IoTopenTech/TTNMAD_CO2_FREE/presentacion/README.MD

Presentación para el montaje y configuración del sensor TTNMAD_CO2_FREE versión Wemos D1 mini, y conexiones para la versión TTGO LoRa32.
