IoTopenTech/TTNMAD_CO2_FREE/media/photo_2020-10-29_13-06-01.jpg

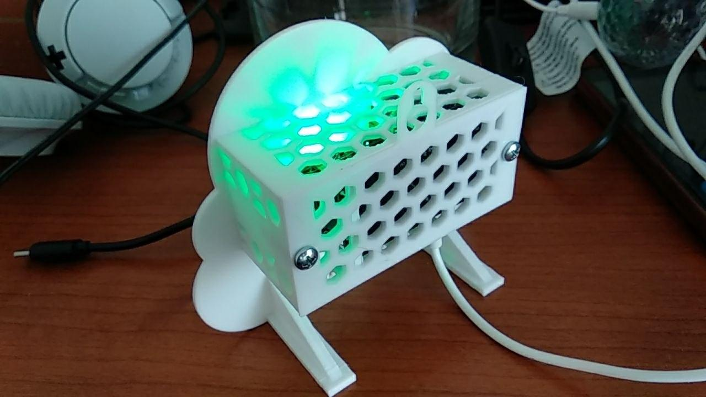
media/photo_2020-10-29_13-06-01.jpg
