IoTopenTech/TTNMAD_CO2_FREE/media/TTNMAD_CO2_FREE_youtube.png

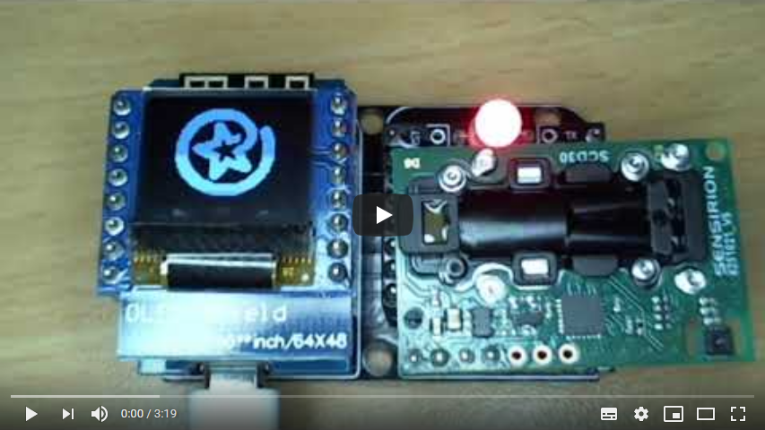
media/TTNMAD_CO2_FREE_youtube.png
