IoTopenTech/TTNMAD_CO2_FREE/presentacion/conexiones_TTGO_LoRa32_SCD30.jpg

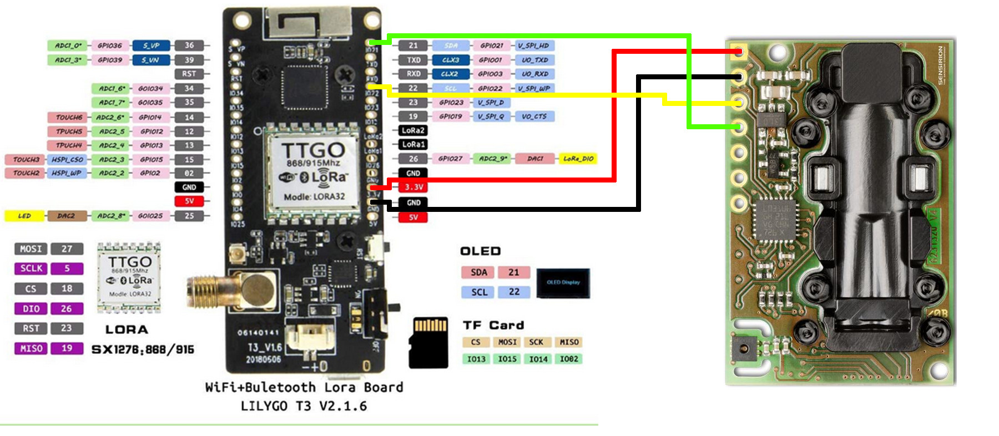
presentacion/conexiones_TTGO_LoRa32_SCD30.jpg
