IoTopenTech/TTNMAD_CO2_FREE/(threads)

Thread 1 (2020-11-09):

Calibrado del sensor

aseques, 2020-11-09:
Hola, mirando varios proyectos he visto que un tema típico es que el sensor de medicion se descalibra al cabo de unas horas de uso. Os ha pasado algo similar?

IoTopenTech, 2020-11-10:
No he observado ese problema @aseques
De hecho, el sensor que hemos elegido (SCD30) tiene un precio algo más elevado que otros, pero ofrece la ventaja de incluir una rutina continua de autocalibración.
Esta rutina exige mantenerlo encendido de forma continua durante al menos 7 días exponiéndolo al menos una hora al día a aire fresco (de este modo el sensor encuentra su referencia mínima).

aseques, 2020-11-11:
Grácias, ya vi que el precio era un el doble que otras opciones (por ejemplo MH-Z19B que usan en https://github.com/oskrs111/diy-co2-monitor), supongo que será por lo que comentais.

IoTopenTech, 2020-11-12:
El Z19B es también una buena opción, que de hecho estuvimos valorando, pero para nuestro caso de uso tenía la limitación principal de consumir casi 3 veces más que el SCD30.
Tampoco trae sensor de humedad, que lo compensa con un filtro de vapor.
Y algo menos de precisión.
Es 3 veces más barato... pero nuestro caso está dirigido a usuarios sin mucha experiencia en sensores, por lo que evitar la calibración es esencial, y aquí una marca de prestigio como Sensirion terminó de inclinar la balanza.

Enoasv, 2021-01-20:
Hola,
Una duda que tengo con el autocalibrado, por si tenéis más información que la que aporta el datasheet...
Con la aplicación para este proyecto se activa siempre la autocalibracioón, pero ¿Que sucede si está encendido y no se cumple el tener al menos una hora al dia con aire "fresco" ¿Se autocalibraria de manera incorrecta?
¿El resultado de la autocalibración se puede ver de alguna manera?
¡Gracias!
